qppd/a.w.a.k.e/model/LM2596 Buck Converter Enclosure - 4096861/images/Buttom.jpg

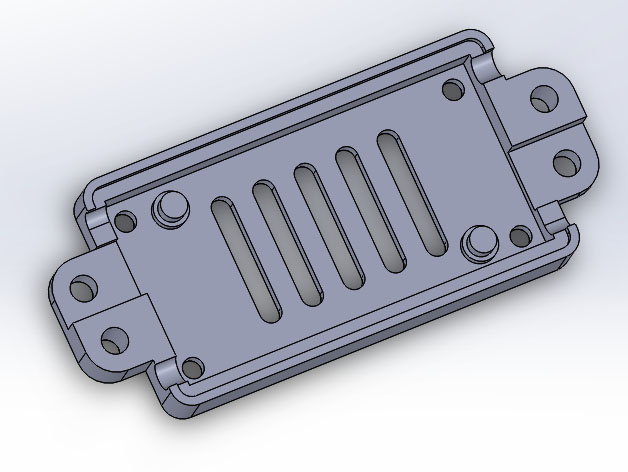
model/LM2596 Buck Converter Enclosure - 4096861/images/Buttom.jpg
