qppd/a.w.a.k.e/model/LM2596 Buck Converter Enclosure - 4096861/images/Top.jpg

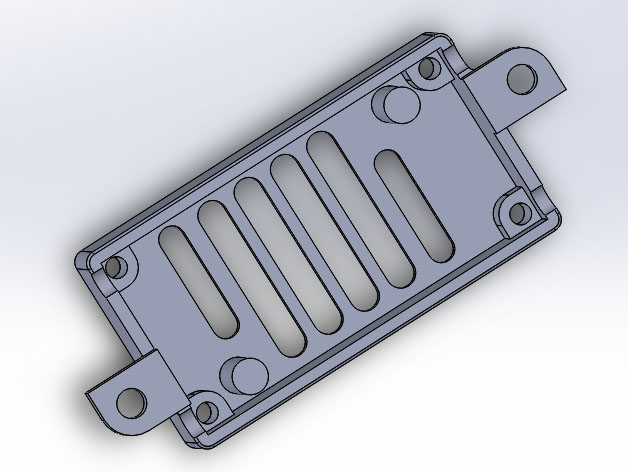
model/LM2596 Buck Converter Enclosure - 4096861/images/Top.jpg
