qppd/a.w.a.k.e/model/LM2596 Buck Converter Enclosure - 4096861/files/Buttom.STL

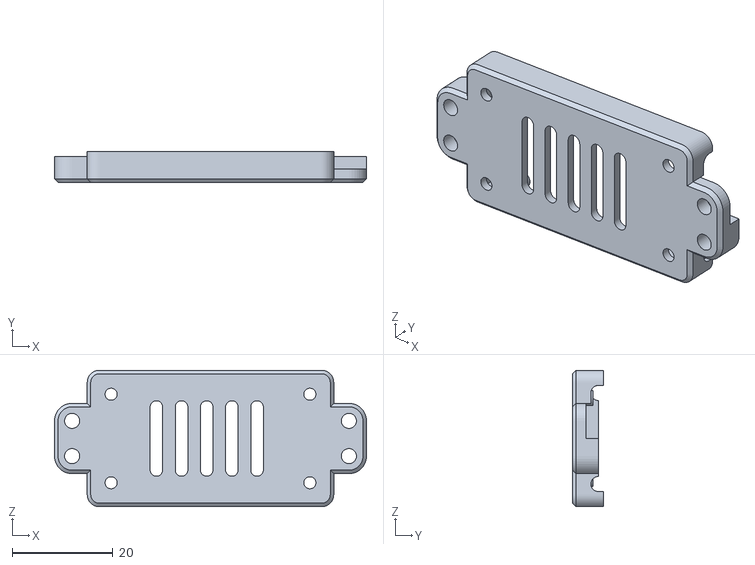
[picture p6: CAD file, 2026-08-31]
model/LM2596 Buck Converter Enclosure - 4096861/files/Buttom.STL
62.0 x 6.15 x 27.1
