qppd/a.w.a.k.e/model/ZalophusDokdo/super-ultra-compact-pan-tilt-camera-mount-v1/vertMount_Cover_RPi_r01.stl

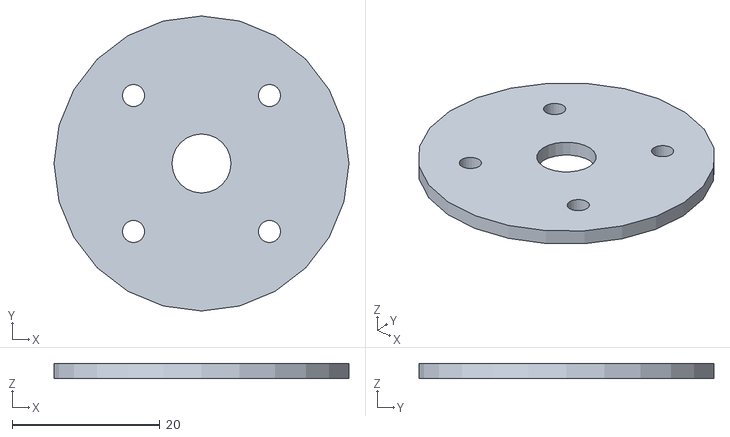
[picture p8: CAD file, 2026-08-24]
model/ZalophusDokdo/super-ultra-compact-pan-tilt-camera-mount-v1/vertMount_Cover_RPi_r01.stl
40.0 x 40.0 x 2.00
