qppd/a.w.a.k.e/model/LM2596 Buck Converter Enclosure - 4096861/files/Top-02.STL

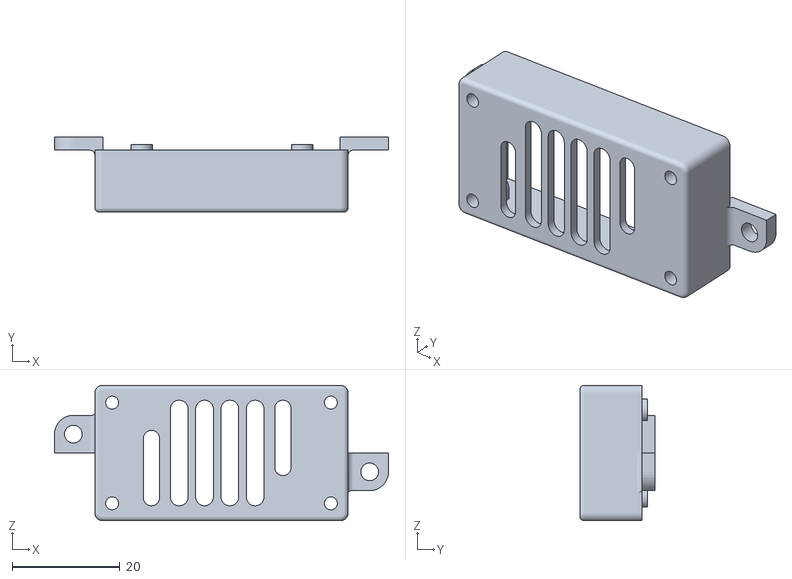
[picture p9: CAD file, 2026-08-31]
model/LM2596 Buck Converter Enclosure - 4096861/files/Top-02.STL
62.0 x 14.0 x 25.1
