qppd/a.w.a.k.e/model/Qppd/Rpi_Case.stl

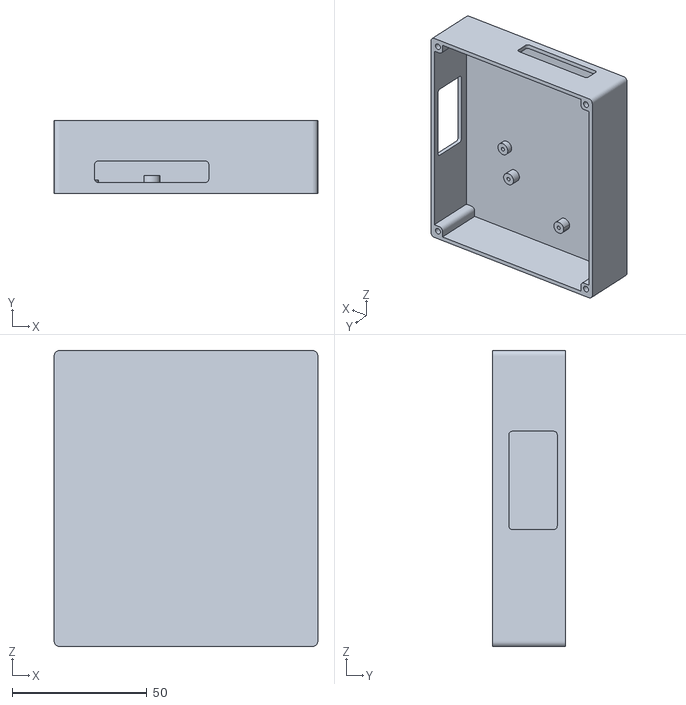
[picture p10: CAD file, 2026-08-31]
model/Qppd/Rpi_Case.stl
98.0 x 27.0 x 110.0
