qppd/a.w.a.k.e/model/Qppd/Camera_Mount_Arm_Left.stl

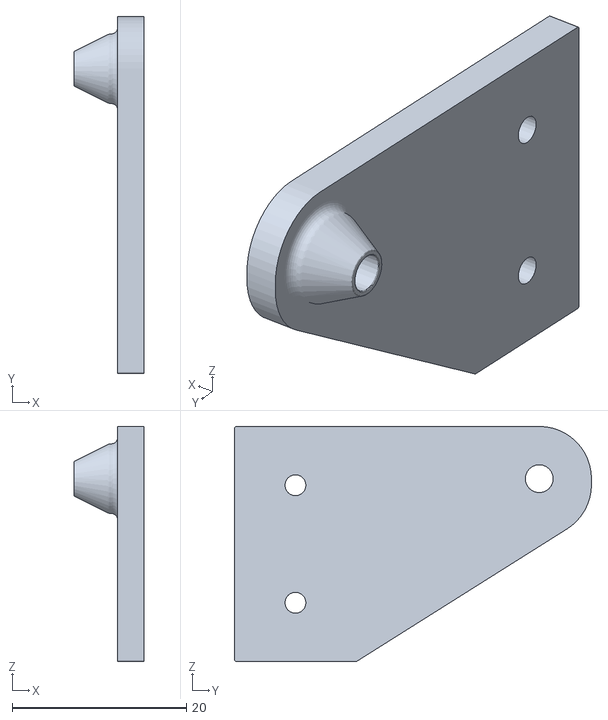
[picture p13: CAD file, 2026-08-31]
model/Qppd/Camera_Mount_Arm_Left.stl
8.00 x 41.0 x 27.0
