qppd/a.w.a.k.e/model/ZalophusDokdo/super-ultra-compact-pan-tilt-camera-mount-v1/PanTiltbase_RPi_r01.stl

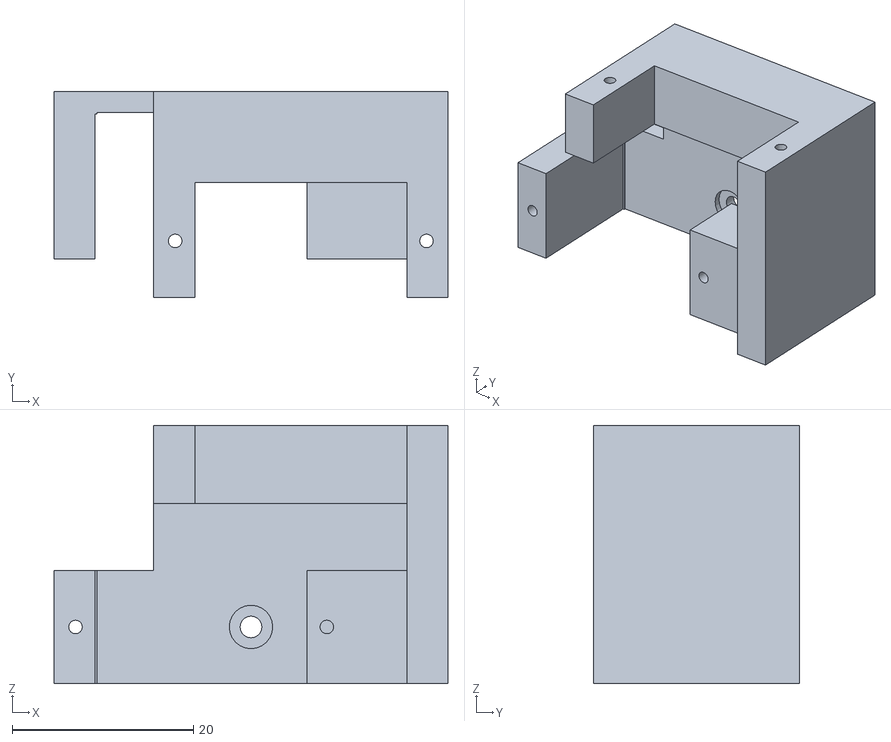
[picture p14: CAD file, 2026-08-24]
model/ZalophusDokdo/super-ultra-compact-pan-tilt-camera-mount-v1/PanTiltbase_RPi_r01.stl
43.5 x 22.7 x 28.5
