qppd/a.w.a.k.e/model/Qppd/Rpi_Case_Cover.stl

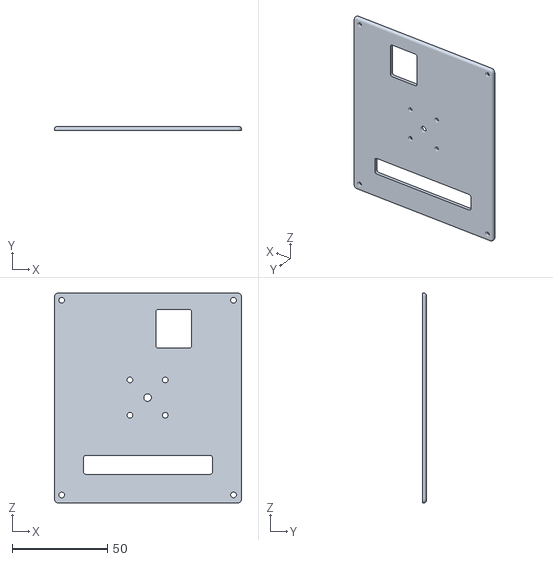
[picture p15: CAD file, 2026-08-31]
model/Qppd/Rpi_Case_Cover.stl
98.0 x 2.00 x 110.0
