qppd/a.w.a.k.e/model/ZalophusDokdo/super-ultra-compact-pan-tilt-camera-mount-v1/cameraMount_RPi_R_r01.stl

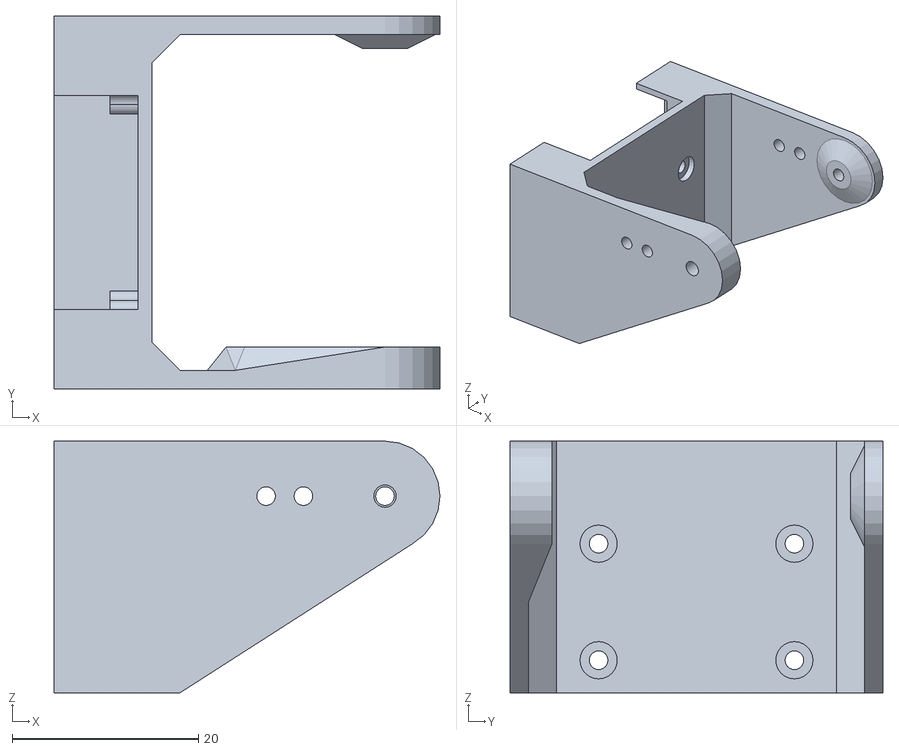
[picture p18: CAD file, 2026-08-24]
model/ZalophusDokdo/super-ultra-compact-pan-tilt-camera-mount-v1/cameraMount_RPi_R_r01.stl
41.4 x 40.0 x 27.0
