qppd/a.w.a.k.e/model/ZalophusDokdo/super-ultra-compact-pan-tilt-camera-mount-v1/cameraCover_RPi_r01.stl

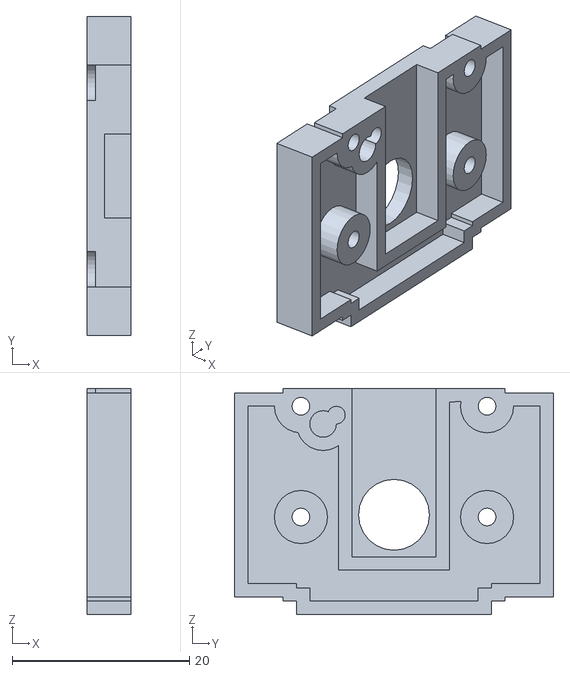
[picture p19: CAD file, 2026-08-24]
model/ZalophusDokdo/super-ultra-compact-pan-tilt-camera-mount-v1/cameraCover_RPi_r01.stl
5.00 x 36.0 x 25.5
