qppd/a.w.a.k.e/(list of files, cad)

Other CAD files:
model/LM2596 Buck Converter Enclosure - 4096861/files/Top.STL
