qppd/a.w.a.k.e/docs/data-result.csv

Item_No | Component | Test_Description | Test_Method | Input_Condition | Expected_Result | Actual_Result | Rating | Remarks
1.0 | Face Detection | Detect face in camera frame (front-facing) | Functional Testing | Subject facing camera with eyes open | Face bounding box detected and returned | Face detected with bounding box and landmarks | 5 | MediaPipe face mesh works in headless mode
2.0 | Face Detection | Fail detection when no face is present | Functional Testing | Subject turns away from camera | No face returned (None) | No face detected returns None | 5 | Correctly handles no-face scenario
3.0 | Face Detection | Detect face under normal indoor lighting | Functional Testing | Subject under fluorescent room lighting | Face detected consistently | Face detected with consistent bounding box | 5 | Works under standard indoor conditions
4.0 | Face Detection | Detect face in low-light conditions | Functional Testing | Subject in dimly lit room | Face detected with reduced confidence | Face detection fails or drops frames | 2 | MediaPipe struggles in low-light environments
5.0 | EAR Calculation | Compute EAR when eyes are fully open | Functional Testing | Subject with eyes wide open | EAR value > 0.25 | EAR = 0.32 | 5 | Correctly computes eye openness
6.0 | EAR Calculation | Compute EAR when eyes are fully closed | Functional Testing | Subject with eyes fully shut | EAR value < 0.15 | EAR = 0.08 | 5 | Correctly detects closed eyes
7.0 | EAR Calculation | Compute EAR during normal blinking | Functional Testing | Subject blinks naturally (15-20 per minute) | EAR dips below threshold briefly then recovers | EAR dips to 0.09 then returns to 0.30 | 5 | Blinks correctly identified as transient
8.0 | EAR Calculation | EAR threshold triggers at correct value | Functional Testing | EAR threshold set to 0.20 | Eyes classified as closed when EAR < 0.20 | Eyes classified as closed when EAR < 0.20 | 5 | Threshold accurately distinguishes open vs closed
9.0 | PERCLOS Calculation | Compute PERCLOS over 60-second window | Functional Testing | Subject with eyes open for full minute | PERCLOS value near 0.00 | PERCLOS = 0.02 | 5 | Near-zero PERCLOS when eyes open
10.0 | PERCLOS Calculation | PERCLOS increases with prolonged eye closure | Functional Testing | Subject closes eyes for 10 seconds continuously | PERCLOS increases proportionally | PERCLOS = 0.17 (10s closed / 60s window) | 5 | PERCLOS correctly accumulates closed frames
11.0 | PERCLOS Calculation | PERCLOS threshold triggers drowsiness alert | Functional Testing | PERCLOS exceeds 0.20 threshold | System classifies as drowsy | System classifies as drowsy when PERCLOS > 0.20 | 5 | Threshold correctly triggers drowsiness state
12.0 | Drowsiness Detection | Alert when eyes closed > 45 consecutive frames | Functional Testing | Subject keeps eyes closed for 3 seconds | Drowsiness detected after threshold reached | Drowsiness detected after 45 frames | 5 | Consecutive frame threshold works correctly
13.0 | Drowsiness Detection | No false positive during normal driving posture | Functional Testing | Subject with eyes open looking at road for 5 minutes | No drowsiness alert triggered | No false positives during 5-minute test | 5 | Low false positive rate
14.0 | Drowsiness Detection | Detect drowsiness during actual sleep episode | Functional Testing | Subject closes eyes and simulates falling asleep | Drowsiness alert triggered within 3 seconds | Alert triggered after 2.5 seconds | 5 | Real-time detection of drowsiness event
15.0 | Drowsiness Detection | Recover from drowsy state when eyes reopen | Functional Testing | Subject opens eyes after being detected as drowsy | System returns to alert state | System returns to alert state within 2 seconds | 4 | Recovery detection slight delay
16.0 | Alarm System | Alarm triggers when drowsiness is detected | Functional Testing | Drowsiness state becomes active | Buzzer sounds and vibration activates | Buzzer sounds and vibration activates | 5 | Alarm output functions correctly
17.0 | Alarm System | Alarm stops when subject becomes alert | Functional Testing | Subject opens eyes after alarm | Buzzer and vibration stop | Buzzer and vibration stop | 5 | Alarm clears on recovery
18.0 | Alarm System | Alarm cooldown prevents repeated triggers | Functional Testing | Rapid drowsy-alert-drowsy transitions | Alarm respects 5-second cooldown between triggers | Alarm respects cooldown no repeated rapid triggers | 5 | Cooldown prevents nuisance alarms
19.0 | Calibration | EAR threshold calibration runs correctly | Functional Testing | Run calibration mode with 30 open-eye samples | Calibration computes optimal threshold value | Calibration completed threshold set to 0.19 | 5 | Calibration produces accurate threshold
20.0 | Calibration | Calibration adapts to individual user | Functional Testing | Different subjects run calibration | Each subject gets personalized threshold | Threshold varies by subject (0.17-0.22) | 4 | Accounts for individual eye geometry differences
21.0 | System Integration | Full drowsiness detection loop runs continuously | Functional Testing | Program runs for 10 minutes in headless mode | System processes frames without crashes | System ran 10 minutes without errors | 5 | Stable continuous operation
22.0 | System Integration | Frame rate maintained during detection | Performance Testing | Monitor FPS during face + eye detection loop | FPS should be >= 20 for real-time detection | Frame rate approximately 25 fps | 5 | Real-time performance maintained
23.0 | System Integration | Terminal output shows detection status | Functional Testing | Monitor terminal during operation | Terminal shows EAR PERCLOS and drowsiness status | Terminal displays live EAR and PERCLOS values | 5 | Headless output works correctly
24.0 | System Integration | Log file records detection data | Functional Testing | Check logs/drowsiness_log.csv after session | CSV contains timestamped detection data | Log file contains all recorded frames with EAR PERCLOS status | 5 | Data logging functional
25.0 | System Integration | Program handles camera disconnection gracefully | Error Testing | Disconnect camera during operation | Program reports error and exits cleanly | Program reports No frame and retries | 4 | Handles camera loss without crashing
26.0 | Detection Accuracy | True Positive Rate (Sensitivity) | Accuracy Testing | 10 trials subject closes eyes to simulate drowsiness | System detects drowsiness in all trials | System detected drowsiness in 9 out of 10 trials | 5 | True Positive Rate = 90%
27.0 | Detection Accuracy | True Negative Rate (Specificity) | Accuracy Testing | 10 trials subject keeps eyes open for 5 minutes | System does not trigger false alarm | System triggered 0 false alarms in 10 trials | 5 | True Negative Rate = 100%
28.0 | Detection Accuracy | Overall Detection Accuracy | Accuracy Testing | 20 total trials (10 drowsy + 10 alert) | Accuracy should be >= 85% | 18 correct detections out of 20 trials | 5 | Overall Accuracy = 90%
29.0 | Detection Accuracy | EAR-based eye closure detection accuracy | Accuracy Testing | 50 blink samples vs ground truth | EAR correctly classifies open/closed state | 47 correct out of 50 samples | 5 | EAR accuracy = 94%
30.0 | Detection Accuracy | PERCLOS threshold detection accuracy | Accuracy Testing | 5 trials with varying eye closure durations | PERCLOS correctly identifies drowsy vs alert | 4 correct out of 5 trials | 4 | PERCLOS accuracy = 80%
31.0 | Time of Response | Time from eye closure to alarm trigger | Response Time Testing | Subject closes eyes and holds for 5 seconds | Alarm triggers within 3 seconds of eye closure | Alarm triggered at 2.5 seconds | 5 | Response time = 2.5s
32.0 | Time of Response | Time from alert state to alarm stop | Response Time Testing | Subject opens eyes after alarm triggers | Alarm stops within 2 seconds of eyes opening | Alarm stopped at 1.8 seconds | 5 | Recovery time = 1.8s
33.0 | Time of Response | Time from face detected to first EAR computation | Response Time Testing | Subject enters camera frame | First EAR computed within 1 second | First EAR computed at 0.4 seconds | 5 | Initialization time = 0.4s
34.0 | Time of Response | Time from PERCLOS threshold exceeded to alarm | Response Time Testing | Subject keeps eyes closed until PERCLOS > 0.20 | Alarm triggers within 1 second of PERCLOS threshold | Alarm triggered at 0.6 seconds after threshold | 5 | PERCLOS response time = 0.6s
35.0 | Time of Response | Average frame processing time | Performance Testing | Monitor per-frame processing time over 60 seconds | Average frame time should be < 40ms (25fps) | Average frame time = 38ms | 5 | Frame processing = 38
