qppd/a.w.a.k.e/src/awake/pan_tilt.py

"""A.W.A.K.E. 2.0 — Pan/Tilt Servo Control Module

GPIO pins (BCM):
  Pan  → GPIO 12  — 360° continuous rotation servo (speed/direction via PWM)
  Tilt → GPIO 13  — Standard positional servo (angle via PWM)

Both use RPi.GPIO software PWM at 50 Hz.
"""
from __future__ import annotations

import logging
import math
import time

from .config import CFG

logger = logging.getLogger(__name__)

# ── PWM spec ───────────────────────────────────────────────
PWM_FREQ_HZ   = 50       # 50 Hz standard servo PWM
PULSE_MIN_US  = 500      # CFG.servo_min_pulse_us
PULSE_MAX_US  = 2500     # CFG.servo_max_pulse_us
NEUTRAL_US    = 1500     # stop / centre for both servos
PWM_PERIOD_US = 1_000_000 // PWM_FREQ_HZ   # 20 000 µs

# ── Tilt positional range (standard servo) ─────────────────
TILT_MIN_DEG = 0.0       # physical 0°
TILT_MAX_DEG = 180.0     # physical 180°

# ── Pan speed mapping (continuous rotation) ────────────────
# Negative error → forward, positive error → reverse
# Speed proportional to error, clamped to valid pulse range


class PanTilt:

    def __init__(self) -> None:
        self._gpio = None
        self._pan_pwm = None
        self._tilt_pwm = None
        self._tilt_angle: float = CFG.tilt_centre_angle  # front-facing home angle
        self._has_gpio = False
        self._pigpio_pi = None  # pigpio instance for GPIO12 (HW PWM workaround)
        # Tilt servo stability: stop PWM after movement, cooldown, angle deadband
        self._tilt_cooldown_until: float = 0.0
        self._tilt_moving_since: float | None = None
        self._face_last_seen: float = 0.0  # timestamp of last face detection
        self._tilt_target_angle: float | None = None  # smoothed target angle for smooth stepping

    # ── Init ────────────────────────────────────────────────

    def init(self) -> None:
        # ── Try pigpio first for the pan servo (GPIO 12) ──────────
        # GPIO 12 is a hardware-PWM pin; RPi.GPIO HW-PWM can produce
        # inaccurate pulse widths that prevent continuous-rotation
        # servos from responding.  pigpio gives cycle-accurate output.
        try:
            import pigpio
            pi = pigpio.pi()
            if pi.connected:
                self._pigpio_pi = pi
                pi.set_mode(CFG.servo_pan_gpio, pigpio.OUTPUT)
                pi.set_servo_pulsewidth(CFG.servo_pan_gpio, NEUTRAL_US)
                logger.info(
                    "Pan servo initialised via pigpio (GPIO %d)",
                    CFG.servo_pan_gpio,
                )
            else:
                logger.warning("pigpio daemon not running — will fall back to RPi.GPIO")
        except (ImportError, OSError):
            logger.debug("pigpio not available — will use RPi.GPIO for pan")

        try:
            import RPi.GPIO as gpio
            gpio.setmode(gpio.BCM)

            # Pan — continuous rotation servo (only if pigpio not used)
            if self._pigpio_pi is None:
                gpio.setup(CFG.servo_pan_gpio, gpio.OUT, initial=gpio.LOW)
                self._pan_pwm = gpio.PWM(CFG.servo_pan_gpio, PWM_FREQ_HZ)
                self._pan_pwm.start(_pulse_to_duty(NEUTRAL_US))

            # Tilt — standard positional servo
            gpio.setup(CFG.servo_tilt_gpio, gpio.OUT, initial=gpio.LOW)
            self._tilt_pwm = gpio.PWM(CFG.servo_tilt_gpio, PWM_FREQ_HZ)
            self._tilt_pwm.start(_pulse_to_duty(_angle_to_pulse(CFG.tilt_centre_angle)))

            self._gpio = gpio
            self._has_gpio = True
            logger.info(
                "PanTilt initialised (pan=%d via %s, tilt=%d via RPi.GPIO)",
                CFG.servo_pan_gpio,
                "pigpio" if self._pigpio_pi else "RPi.GPIO",
                CFG.servo_tilt_gpio,
            )
        except (ImportError, RuntimeError) as exc:
            if self._pigpio_pi is None:
                logger.warning("RPi.GPIO unavailable (%s) — using simulation mode", exc)
            self._has_gpio = False

    # ── Public API ──────────────────────────────────────────

    def update(self, face_center: tuple[int, int], frame_size: tuple[int, int]) -> None:
        """Move servos to track the face centre.

        Pan (continuous rotation): speed proportional to horizontal error.
        Tilt (positional): slowly and smoothly steps toward the target angle.
        """
        fw, fh = frame_size
        fcx, fcy = face_center
        error_x = fcx - fw // 2
        error_y = fcy - fh // 2

        # ── Pan: continuous rotation — speed from error_x ──
        # Face right of centre (error > 0) → pan right → pulse < 1500
        # Face left of centre  (error < 0) → pan left  → pulse > 1500
        if abs(error_x) > CFG.pan_tilt_deadband:
            pan_pulse = _error_to_pan_pulse(error_x, fw)
            self._set_pan_pulse(pan_pulse)
        else:
            self._set_pan_pulse(NEUTRAL_US)

        # ── Tilt: positional servo — smooth, slow stepping ────
        now = time.time()

        # Map frame position to raw desired angle.
        # Bottom of frame (error_y > 0) → 165° (front-facing)
        # Top of frame    (error_y < 0) → 135°
        half_frame = fh / 2.0
        tilt_half_range = (CFG.tilt_max_angle - CFG.tilt_min_angle) / 2.0
        raw_desired = _clamp(
            CFG.tilt_centre_angle + (error_y / half_frame) * tilt_half_range,
            CFG.tilt_min_angle,
            CFG.tilt_max_angle,
        )

        # Exponential smoothing: blend raw desired with previous target
        # to filter out frame-to-frame jitter
        if self._tilt_target_angle is None:
            self._tilt_target_angle = raw_desired
        else:
            alpha = CFG.tilt_smooth_alpha
            self._tilt_target_angle = (
                alpha * raw_desired + (1.0 - alpha) * self._tilt_target_angle
            )

        # Clamp the smoothed target to valid range
        self._tilt_target_angle = _clamp(
            self._tilt_target_angle,
            CFG.tilt_min_angle,
            CFG.tilt_max_angle,
        )

        # Calculate how far we need to move
        diff = self._tilt_target_angle - self._tilt_angle

        # Angle deadband — ignore tiny corrections
        if abs(diff) < CFG.tilt_angle_deadband:
            self._face_last_seen = now
            self._disconnect_tilt()  # stop PWM completely — servo rests
            logger.debug(
                "Tilt: target=%.1f°  current=%.1f°  diff=%.1f° < deadband — holding",
                self._tilt_target_angle, self._tilt_angle, diff,
            )
            return

        # Step slowly toward the target — clamp step size
        step = _clamp(diff, -CFG.tilt_step_per_frame, CFG.tilt_step_per_frame)
        new_angle = self._tilt_angle + step
        new_angle = _clamp(new_angle, CFG.tilt_min_angle, CFG.tilt_max_angle)

        logger.debug(
            "Tilt: target=%.1f°  current=%.1f°  step=%.2f° → new=%.1f°",
            self._tilt_target_angle, self._tilt_angle, step, new_angle,
        )

        self._tilt_angle = new_angle
        self._apply_tilt()
        self._face_last_seen = now

    def search(self) -> None:
        """Sweep pan and tilt servos back and forth when no face detected.

        Pan sweeps ±30° around neutral.
        Tilt waits tilt_face_lost_timeout seconds, then sweeps
        tilt_search_min–tilt_search_max back and forth.
        """
        now = time.time()

        # Pan: continuous rotation sweep
        pan_sweep = 30 * math.sin(now * 0.5)
        pan_pulse = NEUTRAL_US + (pan_sweep / 60.0) * (PULSE_MAX_US - NEUTRAL_US)
        self._set_pan_pulse(pan_pulse)

        # Tilt: respect moving/cooldown state from update()
        if self._tilt_moving_since is not None:
            if now - self._tilt_moving_since >= CFG.tilt_move_time:
                self._hold_tilt_position()
                self._tilt_moving_since = None
                self._tilt_cooldown_until = now + CFG.tilt_cooldown_seconds
            return  # still moving or just finished — skip this frame

        if now < self._tilt_cooldown_until:
            return

        # Don't search tilt until face has been gone for the timeout
        if now - self._face_last_seen < CFG.tilt_face_lost_timeout:
            return

        # Tilt: sweep within search range back and forth
        search_range = CFG.tilt_search_max - CFG.tilt_search_min
        search_centre = (CFG.tilt_search_min + CFG.tilt_search_max) / 2.0
        tilt_sweep = (search_range / 2.0) * math.sin(now * 0.3)
        target_tilt = _clamp(search_centre + tilt_sweep, CFG.tilt_search_min, CFG.tilt_search_max)
        if abs(self._tilt_angle - target_tilt) > 0.5:
            self._tilt_angle = target_tilt
            self._apply_tilt()

    def centre(self) -> None:
        """Centre both servos — stop pan, tilt to front-facing home angle."""
        self._set_pan_pulse(NEUTRAL_US)
        self._tilt_angle = CFG.tilt_centre_angle
        self._apply_tilt()

    def release(self) -> None:
        """Stop PWM and release GPIO."""
        # Stop pan servo
        if self._pigpio_pi is not None:
            self._pigpio_pi.set_servo_pulsewidth(CFG.servo_pan_gpio, 0)  # release pulse
            self._pigpio_pi.stop()
            self._pigpio_pi = None
        elif self._has_gpio and self._pan_pwm is not None:
            self._pan_pwm.ChangeDutyCycle(_pulse_to_duty(NEUTRAL_US))

        if self._has_gpio and self._gpio is not None:
            # Centre tilt
            if self._tilt_pwm is not None:
                self._tilt_pwm.ChangeDutyCycle(_pulse_to_duty(NEUTRAL_US))

            import time
            time.sleep(0.1)

            if self._pan_pwm is not None:
                self._pan_pwm.stop()
                self._pan_pwm = None
            if self._tilt_pwm is not None:
                self._tilt_pwm.stop()
                self._tilt_pwm = None

            self._gpio.output(CFG.servo_pan_gpio, False)
            self._gpio.output(CFG.servo_tilt_gpio, False)
            self._gpio.cleanup([CFG.servo_pan_gpio, CFG.servo_tilt_gpio])
        logger.info("PanTilt released")

    # ── Private helpers ─────────────────────────────────────

    def _set_pan_pulse(self, pulse_us: float) -> None:
        """Set pan servo pulse width (continuous rotation: speed/direction)."""
        clamped = _clamp(pulse_us, PULSE_MIN_US, PULSE_MAX_US)
        if self._pigpio_pi is not None:
            self._pigpio_pi.set_servo_pulsewidth(CFG.servo_pan_gpio, clamped)
        elif self._has_gpio and self._pan_pwm is not None:
            duty = _pulse_to_duty(clamped)
            self._pan_pwm.ChangeDutyCycle(duty)

    def _apply_tilt(self) -> None:
        """Apply current tilt angle to the servo."""
        pulse = _angle_to_pulse(self._tilt_angle)
        duty = _pulse_to_duty(pulse)
        if self._has_gpio and self._tilt_pwm is not None:
            self._tilt_pwm.ChangeDutyCycle(duty)

    def _hold_tilt_position(self) -> None:
        """Hold the tilt servo at its current angle (re-apply position pulse)."""
        self._apply_tilt()

    def _disconnect_tilt(self) -> None:
        """Stop tilt PWM completely — servo rests with no signal."""
        if self._has_gpio and self._tilt_pwm is not None:
            self._tilt_pwm.ChangeDutyCycle(0)

    @property
    def angles(self) -> tuple[float, float]:
        """Return (pan_pulse_us, tilt_angle_deg)."""
        return 0.0, self._tilt_angle


# ── Module-level helpers ────────────────────────────────────

def _pulse_to_duty(pulse_us: float) -> float:
    """Convert pulse width in µs → PWM duty cycle (%)."""
    return pulse_us / PWM_PERIOD_US * 100.0


def _angle_to_pulse(angle: float) -> int:
    """Convert physical servo angle (0–180°) → pulse width in µs."""
    norm = (angle - TILT_MIN_DEG) / (TILT_MAX_DEG - TILT_MIN_DEG)
    return int(PULSE_MIN_US + norm * (PULSE_MAX_US - PULSE_MIN_US))


def _error_to_pan_pulse(error_x: int, frame_width: int) -> float:
    """Convert horizontal pixel error to pan servo pulse width.

    error_x > 0 → face right → pan right → pulse < 1500 (spin right)
    error_x < 0 → face left  → pan left  → pulse > 1500 (spin left)
    """
    max_error = frame_width / 2
    norm = max(-1.0, min(1.0, error_x / max_error))

    # Asymmetric range: reverse (left) needs wider offset to overcome friction
    if norm >= 0:
        # Pan right: 1300 → 500 µs
        return 1300.0 - norm * 800.0
    else:
        # Pan left: 1800 → 2500 µs (wider range to overcome friction)
        return 1800.0 + abs(norm) * 700.0


def _clamp(value: float, lo: float, hi: float) -> float:
    return max(lo, min(hi, value))
