qppd/a.w.a.k.e/(commit log)

2026-08-24 Initial commit: S.A.F.E. 2.0 drowsiness detection system
    Modular Python project with camera, face/eye tracking (MediaPipe),
    EAR/PERCLOS computation, pan/tilt servo control, alarm, calibration,
    headless mode, and 33 unit tests.
    🤖 Generated with Codebuff
    [PanTiltbase_RPi_r01.stl, cameraCover_RPi_r01.stl, cameraMount_RPi_R_r01.stl, cameraMount_RPi_r01.stl, cameraMount_r01.stl, vertMount_Cover_RPi_r01.stl, vertMount_RPi_r01.stl]
2026-08-24 Add comprehensive README with setup, usage, wiring, and docs
    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
2026-08-24 Add author info to README
    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
2026-08-24 Add standalone MIT LICENSE file
    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
2026-08-24 Add CONTRIBUTING.md with contribution guidelines
    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
2026-08-24 Add CHANGELOG.md with version history
    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
2026-08-24 Update hardware specs from Pi 5/8GB to Pi 4/4GB in documentation
    Reflect the actual target hardware: Raspberry Pi 4 with 4 GB RAM
    across README and initial-plan BOM/wiring sections.
    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
2026-08-25 Rename project from S.A.F.E. to A.W.A.K.E.
    Rename the project across all files: directory src/safe → src/awake,
    class SafeApp → AwakeApp, logger safe2 → awake2, and all doc
    references. All 33 tests still pass.
    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
2026-08-31 Fix tilt servo oscillation by making search() respect moving/cooldown state
    search() was directly overriding _tilt_angle and calling _apply_tilt()
    without checking _tilt_moving_since or _tilt_cooldown_until, causing
    conflicts when transitioning between search and update() modes. This
    resulted in the tilt servo continuously adjusting even when the face
    was steady at center.
    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
    [pan_tilt.py]
2026-08-31 Fix tilt servo resetting position by holding pulse instead of killing PWM
    _stop_tilt_pwm() was setting duty cycle to 0, which stops sending
    pulses and causes the servo to lose holding torque. The servo then
    drifts or resets due to gravity. Replaced with _hold_tilt_position()
    that re-applies the position pulse so the servo actively holds its
    angle during cooldown.
    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
    [pan_tilt.py]
2026-08-31 Add tilt angle logging for debugging servo position tracking
    Shows error_y, desired angle, current angle, and state (moving/hold/
    cooldown) on every frame. INFO level for movements, DEBUG for holds.
    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
    [pan_tilt.py]
2026-08-31 Show current tilt angle in headless output and debug overlay
    Adds TILT=<angle>° to the headless terminal print and a TILT line
    to the cv2 debug window so the servo position is visible in real time.
    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
2026-08-31 Set tilt servo front angle to 165° and working range to 135°–175°
    Added tilt_centre_angle (165°) as the front-facing home position.
    Updated update(), search(), centre(), and init to use the new range
    and centre angle from config.
    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
2026-08-31 Fix tilt mapping (bottom=165° top=135°) and disconnect servo at center
    - Flipped tilt formula: bottom of frame → 165°, top → 135°
    - Range now 135°–165° with centre at 150°
    - When face is at center (within deadband), completely disconnect
    tilt servo (duty=0) so it rests with no signal
    - search() waits 3s after face lost before resuming tilt sweep
    - Added tilt_search_min/max and tilt_face_lost_timeout config
    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
    [config.py, pan_tilt.py]
2026-08-31 Smooth tilt servo tracking with exponential filtering and slow stepping
    Replace jump-to-angle + cooldown approach with exponential smoothing
    and 0.3°/frame stepping to eliminate jitter when tracking a face.
    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
    [config.py, pan_tilt.py]
2026-08-31 Add offline model check and boot service file for VNC
    - Add model_exists() check with clear error if download fails (no internet)
    - Add startup warning in main.py with manual download instructions
    - Add awake.service systemd unit file for auto-start on boot via VNC
    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
    [face_tracker.py, main.py]
2026-08-31 Add boot service installer script for Raspberry Pi
    Automates setup: installs deps, downloads model, detects VNC display,
    generates systemd service file, and enables auto-start on boot.
    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
2026-08-31 Fix install script to detect and use virtual environment
    Auto-detects venv in project directory and uses its Python/pip
    instead of system Python, avoiding PEP 668 externally-managed errors.
    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
2026-08-31 Fix ModuleNotFoundError by adding PYTHONPATH=src to service
    The awake module lives under src/ so PYTHONPATH must include it
    for 'python3 -m awake.main' to work from the systemd service.
    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
2026-08-31 Fix VNC boot service: add 10s delay for display readiness
    Qt crashes if VNC isn't ready at boot. Add ExecStartPre sleep 10
    to wait for VNC display before launching the app.
    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
2026-08-31 Fix install script: move Wayland detection before Qt check
    QT_PLATFORM was used before being defined, causing the Wayland
    detection and qt6-wayland install to be skipped.
    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
2026-08-31 Add Qt Wayland fix script for Pi
    Copies system Qt Wayland plugin into OpenCV's bundled Qt directory
    so cv2.imshow works on Wayland-based VNC.
    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
